MARK-VONOO/SMART-BOTTLE-COLLECTION-SYSTEM-/docs/future-development.md

# SMART BCS Future Development

## Overview

SMART BCS is already a functional bottle collection and reward system, but there are several opportunities to improve its reliability, intelligence, scalability, and suitability for wider deployment.

Future development will focus on improving bottle identification, communication, user management, mechanical robustness, energy efficiency, and data analytics.

---

## 1. Improved Bottle Identification

The current system validates bottles mainly using weight.

A future version could combine weight measurement with:

- Computer vision
- Barcode scanning
- Object recognition
- Material detection
- Shape analysis

This would make it possible to distinguish more accurately between valid PET bottles and unsuitable objects.

---

## 2. Camera-Based Verification

A camera module could be added to inspect inserted bottles.

Possible functions include:

- Detecting bottle shape
- Confirming bottle type
- Detecting bottle caps
- Detecting foreign objects
- Identifying damaged or non-recyclable containers

Computer vision could significantly improve classification accuracy.

---

## 3. Barcode and Product Recognition

A barcode scanner could allow SMART BCS to identify specific beverage products.

This could support:

- Product-specific rewards
- Brand-sponsored recycling campaigns
- Deposit-refund schemes
- Recycling statistics by product type

---

## 4. Mobile Application

A dedicated mobile application could allow registered users to:

- View reward balances
- Review recycling history
- Receive notifications
- Redeem rewards
- Locate nearby SMART BCS stations
- Register new RFID or QR identities

This would improve user engagement and reduce dependence on SMS alone.

---

## 5. QR-Code User Identification

Future versions could support QR-code identification alongside RFID.

Users could scan a personal QR code from a mobile phone to begin a registered recycling session.

This would reduce the need for physical RFID cards.

---

## 6. Cloud-Based User Accounts

The current implementation stores reward information locally using ESP32 NVS.

A future version could synchronize user accounts with a cloud database.

This would allow:

- One user account across multiple machines
- Centralized reward balances
- Remote account management
- Recycling history synchronization
- Multi-location deployments

---

## 7. Web Dashboard

A cloud dashboard could provide system administrators with real-time information such as:

- Number of bottles collected
- Number of active users
- Reward points issued
- Bin-level status
- Machine availability
- SMS delivery status
- Fault conditions
- Recycling trends

This would be useful for schools, municipalities, companies, and recycling organizations.

---

## 8. Multi-Station Networking

Multiple SMART BCS units could be connected to a common platform.

Each unit could report:

- Station ID
- Location
- Collection volume
- Full-bin status
- User transactions
- Technical faults

This would allow SMART BCS to operate as part of a larger smart waste-management network.

---

## 9. GPS / GNSS Integration

Future SMART BCS units could include GNSS positioning.

This would allow each machine to report its physical location automatically.

Location information could be useful for:

- Maintenance teams
- Collection planning
- Public station maps
- Recycling analytics
- Deployment optimization

---

## 10. Improved Mechanical Sorting

The current servo-operated mechanism could be redesigned for higher durability and throughput.

Possible improvements include:

- Stronger mechanical linkages
- Reduced friction
- Industrial bearings
- Better bottle guidance
- Larger sorting channels
- Jam detection
- Automatic jam recovery

A future design could also use a geared motor or linear actuator instead of a hobby servo.

---

## 11. Multiple Waste Categories

Future versions could support more than one recyclable material.

Possible categories include:

- PET plastic
- Aluminum cans
- Glass bottles
- Paper
- Other recyclable plastics

This would require additional sensing and sorting mechanisms.

---

## 12. Larger Collection Capacity

A larger storage bin could increase the number of bottles that can be collected before servicing.

Possible improvements include:

- Larger internal storage
- Bottle compaction
- Multiple collection compartments
- Removable collection bins

---

## 13. Bottle Compaction

A bottle compression mechanism could reduce the storage volume of collected PET bottles.

Benefits could include:

- Increased collection capacity
- Reduced collection frequency
- Easier transportation
- Improved storage efficiency

Safety interlocks would be required for any compaction mechanism.

---

## 14. Improved Bin-Level Detection

The current HC-SR04 system provides basic bin-level monitoring.

Future versions could use:

- Multiple ultrasonic sensors
- Time-of-flight sensors
- Load-based bin monitoring
- Optical sensors

This could provide more reliable estimates when bottles are unevenly distributed.

---

## 15. Industrial Power System

The current system can be improved with a more robust power architecture.

Future versions could include:

- Dedicated regulated rails
- Overcurrent protection
- Reverse-polarity protection
- Surge protection
- Proper fusing
- Industrial DC-DC converters
- Battery backup

This would improve reliability for continuous public operation.

---

## 16. Solar-Powered Operation

A solar-powered version could support installations where mains power is unavailable.

A possible system could include:
Solar Panel
    |
Charge Controller
    |
Battery
    |
DC Regulation
    |
SMART BCS

This could make the system suitable for outdoor and remote locations.

---
## 17. Improved Enclosure

A future enclosure could be designed for long-term public use.

Possible improvements include:

Weather-resistant materials
Lockable access panels
Improved ventilation
Internal cable management
Fire-resistant materials
Tamper-resistant fasteners
Improved bottle-entry geometry
Professional branding

---
## 18. Contactless Reward Redemption

Reward points could eventually be redeemed through:

Mobile-money credit
Shopping vouchers
Campus rewards
Transport credit
Discount coupons
Partner loyalty schemes

This could make recycling incentives more practical and attractive.

---
## 19. Mobile Money Integration

For deployments in Ghana and similar markets, a future version could explore mobile-money reward integration.

Users could potentially convert accumulated recycling points into approved digital rewards.

Such functionality would require secure authentication and compliance with payment-provider requirements.

---
## 20. Enhanced Communication Reliability

Future communication improvements could include:

Wi-Fi
GSM / LTE
LoRaWAN
NB-IoT
Ethernet

Using multiple communication options could improve reliability in different deployment environments.

---
## 21. Remote Firmware Updates

Over-the-air firmware updates could allow software improvements without physically opening the machine.

OTA updates could be used for:

Bug fixes
Security updates
New features
Sensor calibration changes
Reward-policy changes

Secure firmware signing would be important for public deployment.

---
## 22. Improved Security

A larger deployment would require stronger security measures.

Possible improvements include:

Encrypted user records
Secure API authentication
Protected firmware
HTTPS certificate verification
Anti-replay protection
Secure account management
Access-control logging

Private credentials should never be stored in public source-code repositories.

---
## 23. Advanced Analytics

Collected data could be analyzed to understand recycling behavior.

Possible metrics include:

Bottles recycled per day
Most active users
Peak recycling periods
Average bottles per session
Station utilization
Rejection rate
Reward points issued
Collection-bin fill rate

These insights could help improve recycling programs.

---
## 24. Predictive Collection Scheduling

With enough historical bin-level data, SMART BCS could predict when a station is likely to become full.

This could allow collection teams to service machines before overflow occurs.

Predictive scheduling could reduce:

Unnecessary collection trips
Overflow
Machine downtime
Operational costs

---
## 25. Commercial and Community Deployment

Future field trials could evaluate SMART BCS in environments such as:

Universities
Senior high schools
Shopping centres
Offices
Events
Transport terminals
Residential communities
Municipal recycling stations

These deployments would provide real-world information about durability, user behavior, maintenance requirements, and economic viability.

## 26. Manufacturing Development

If SMART BCS moves toward larger-scale production, future work would include:

Custom PCB development
Standardized wiring harnesses
Injection-molded or fabricated enclosure
Improved mechanical assemblies
Certification and safety testing
Manufacturing documentation
Quality-control procedures
Long-Term Vision

The long-term vision for SMART BCS is to develop it from a single functional recycling system into a scalable intelligent recycling platform.

A future SMART BCS network could combine:

Smart Collection Stations
        |
        v
Cloud Platform
        |
        +---- User Accounts
        |
        +---- Rewards
        |
        +---- Recycling Analytics
        |
        +---- Bin Monitoring
        |
        +---- Maintenance Alerts
        |
        +---- Municipal / Company Dashboard

The objective is to make recycling more:

Accessible
Intelligent
Traceable
Rewarding
Data-driven
Environmentally sustainable
Collaboration

SMART BCS is open to future collaboration in areas including:

Embedded systems
IoT
Recycling technology
Automation
Mechanical engineering
Computer vision
Cloud platforms
Sustainability
Smart-city technology
Manufacturing

Potential collaboration could include technical development, field testing, research, sponsorship, manufacturing, and deployment.

---

## Author

MARK VONOO

SMART BCS — Smart Bottle Collection System

Ghana
