MARK-VONOO/SMART-BOTTLE-COLLECTION-SYSTEM-/diagrams/electrical-schematic.pdf

# SMART BCS Controller, RFID and power distribution

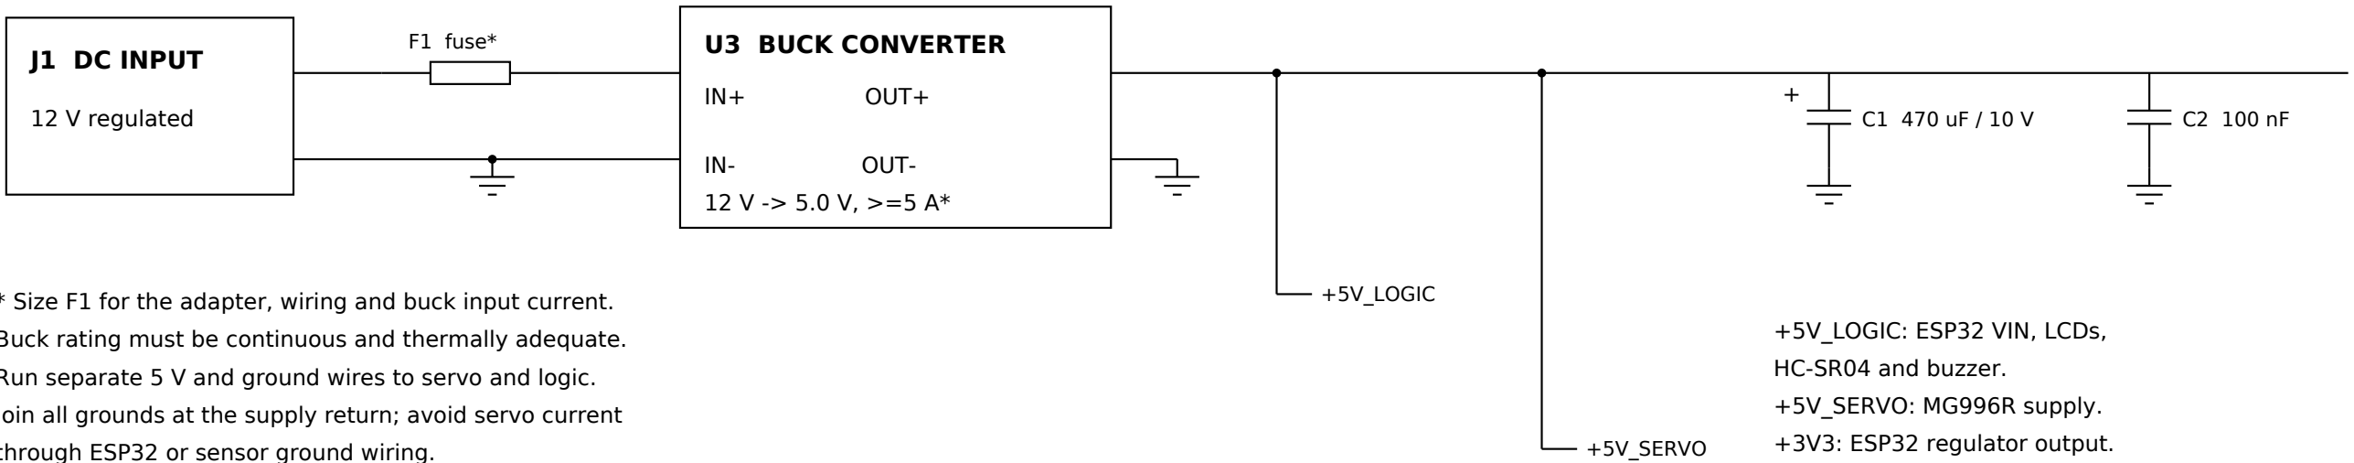
[picture p8: figure]
J1 DC INPUT; 12 V regulated; F1 fuse*; U3 BUCK CONVERTER; OUT+; OUT-; +5V_LOGIC; +5V_LOGIC: ESP32 VIN, LCDs,; HC-SR04 and buzzer.; +5V_SERVO: MG996R supply.; +3V3: ESP32 regulator output.

ELECTRICAL SCHEMATIC | Rev B | 13 Sep 2026 | A3 landscape

GPIO mapping: user-confirmed final build. Interface circuitry is proposed; module outlines show terminals, not physical pin positions.

SHEET 1 OF 3

### U1 ESP32 DevKit / WROOM-32

+5V_LOGIC | 5V / VIN
+3V3 | 3V3
GND | GND
RFID_SS | GPIO5
SPI_SCK | GPIO18
SPI_MOSI | GPIO23
SPI_MISO | GPIO19
RFID_RST | GPIO4
HX_DOUT | GPIO26
HX_SCK | GPIO27
I2C_SDA_3V3 | GPIO21
I2C_SCL_3V3 | GPIO22
GPIO32 | US_TRIG
GPIO33 | US_ECHO_3V3
GPIO13 | SERVO_PWM
GPIO25 | LED_GREEN
GPIO2 | LED_YELLOW
GPIO15 | LED_RED
GPIO14 | BUZZER_EN
GPIO34 | KEY_A
GPIO35 | KEY_B
GPIO36 | KEY_HASH
GPIO39 | KEY_STAR

### U2 RC522 reader

+3V3 | 3.3V
GND | GND
RFID_SS | SDA / SS
SPI_SCK | SCK
SPI_MOSI | MOSI
SPI_MISO | MISO
RFID_RST | RST
IRQ | NC

RC522 SDA is SPI chip select here; it is not I2C SDA. Use 3.3 V power and logic only. IRQ is unconnected. Pin names must be checked against the actual module.

### POWER INPUT AND SEPARATE LOAD BRANCHES

+5V_SERVO

* Size F1 for the adapter, wiring and buck input current. Buck rating must be continuous and thermally adequate. Run separate 5 V and ground wires to servo and logic. Join all grounds at the supply return; avoid servo current
through ESP32 or sensor ground wiring.

Matching net names are electrically connected across all three sheets. Dots indicate junctions; crossings without dots do not connect. Do not feed external 5 V and USB 5 V simultaneously unless your DevKit has verified power isolation.

# SMART BCS Sensor interfaces and dual I2C displays

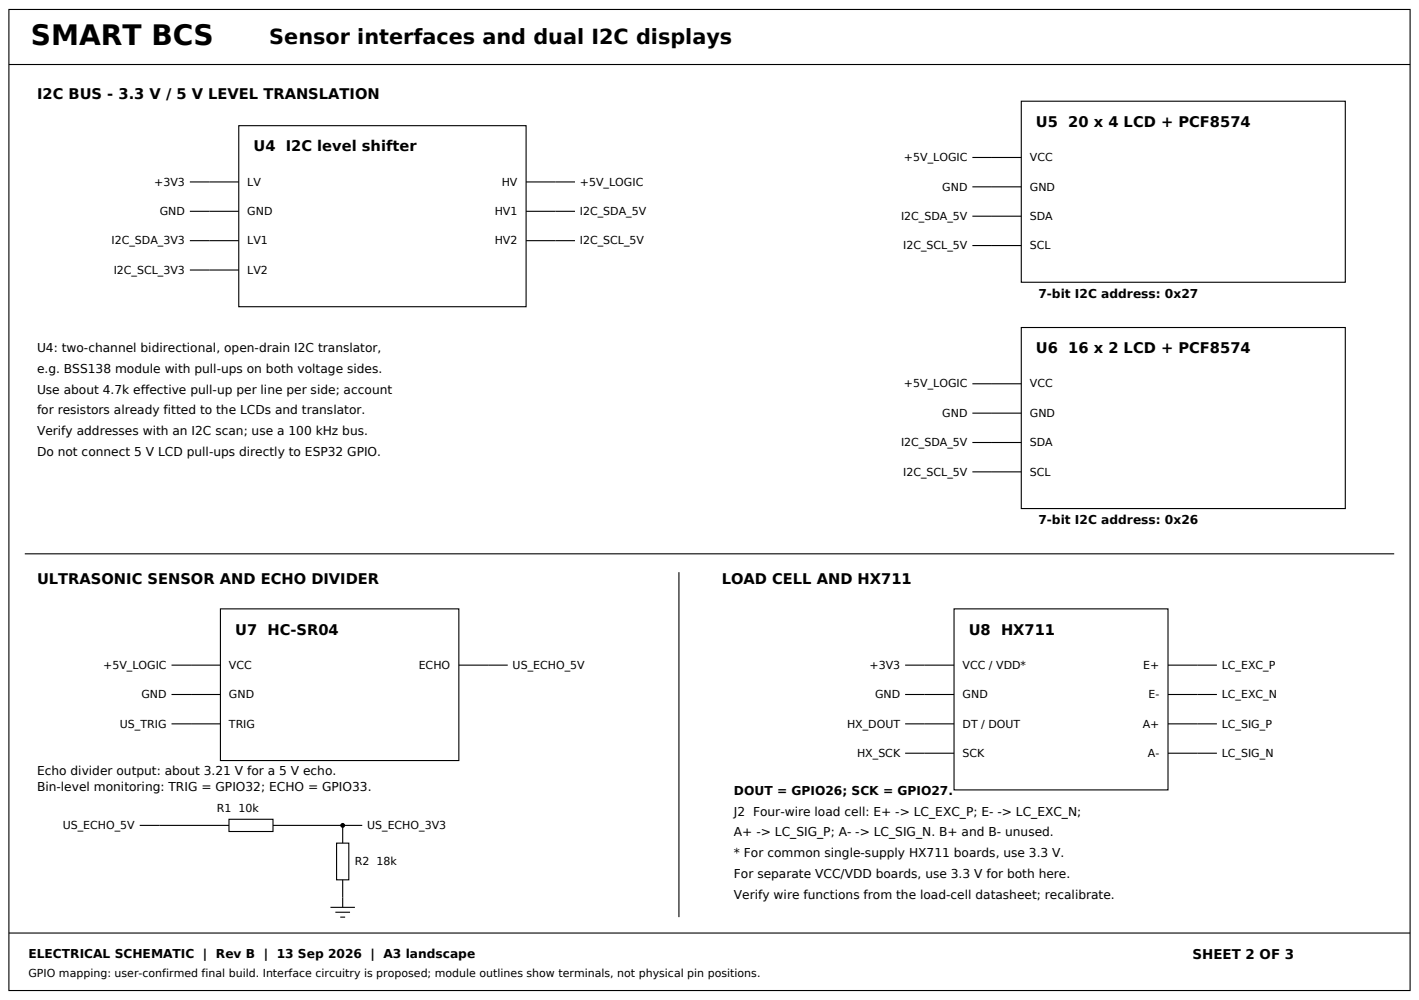
[picture p9: page 2]

U4: two-channel bidirectional, open-drain I2C translator,
e.g. BSS138 module with pull-ups on both voltage sides.
Use about 4.7k effective pull-up per line per side; account
for resistors already fitted to the LCDs and translator.
Verify addresses with an I2C scan; use a 100 kHz bus.
Do not connect 5 V LCD pull-ups directly to ESP32 GPIO.

ULTRASONIC SENSOR AND ECHO DIVIDER

Echo divider output: about 3.21 V for a 5 V echo.
Bin-level monitoring: TRIG = GPIO32; ECHO = GPIO33.

DOUT = GPIO26; SCK = GPIO27.
J2 Four-wire load cell: E+ -> LC_EXC_P; E- -> LC_EXC_N;
A+ -> LC_SIG_P; A- -> LC_SIG_N. B+ and B- unused.
* For common single-supply HX711 boards, use 3.3 V.
For separate VCC/VDD boards, use 3.3 V for both here.
Verify wire functions from the load-cell datasheet; recalibrate.

# SMART BCS Switches, indicators, actuator and build notes

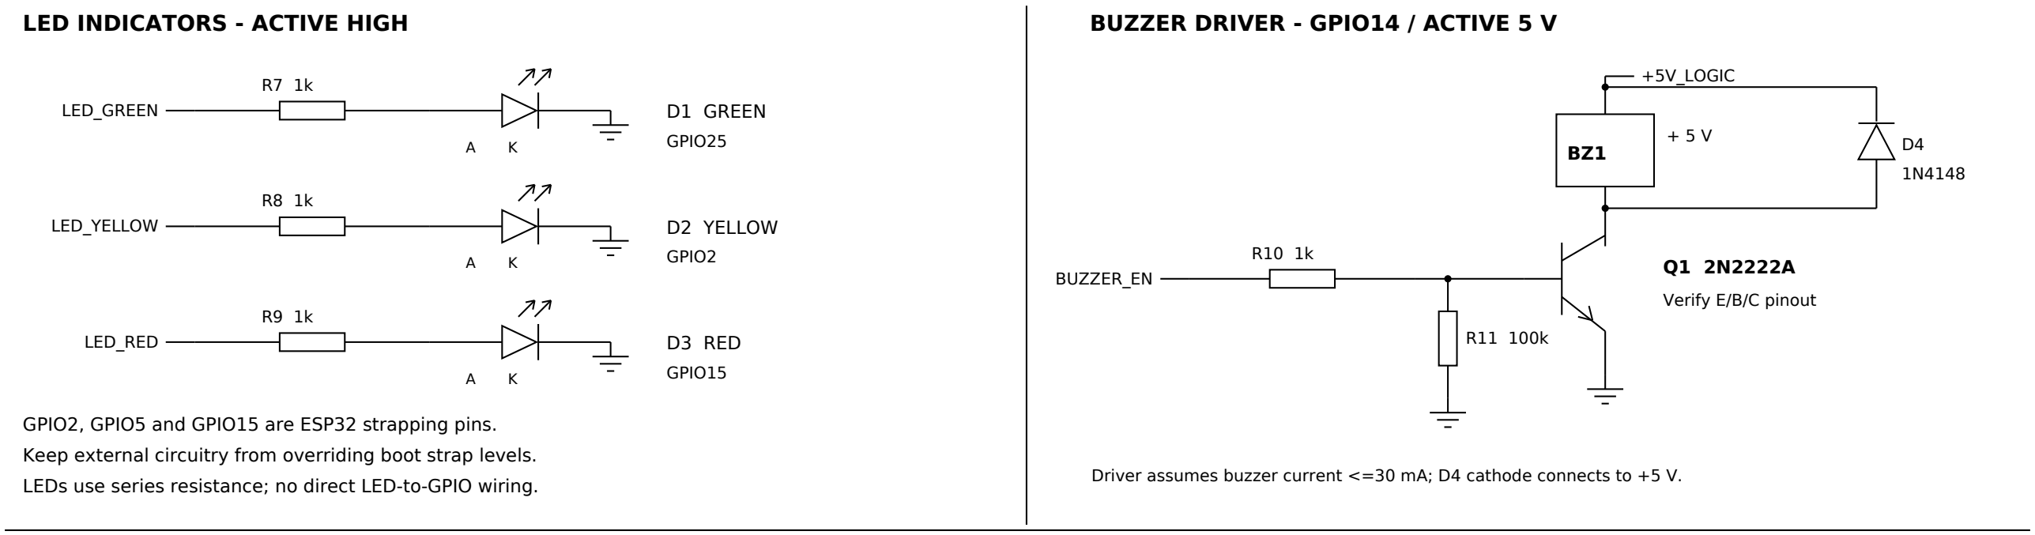
[picture p10: figure]
LED INDICATORS - ACTIVE HIGH; LED_GREEN; D1 GREEN; GPIO25 A; LED_YELLOW; D2 YELLOW; GPIO2 A; LED_RED; D3 RED; GPIO15 A; BUZZER DRIVER - GPIO14 / ACTIVE 5 V; +5V_LOGIC; BUZZER_EN; Verify E/B/C pinout

SHEET 3 OF 3

### FOUR INDEPENDENT NORMALLY OPEN SWITCHES

+3V3

R3 10k

KEY_A

SW1 A

GPIO34

+3V3

R4 10k

KEY_B

SW2 B

GPIO35

+3V3

R5 10k

KEY_HASH

SW3 #

GPIO36

+3V3

R6 10k

KEY_STAR

SW4 *

GPIO39

Pressed = LOW. Each key closes only its own GPIO to ground.
All four keys use input-only GPIOs; fit the 10k pull-ups shown. Four-pin pushbuttons have internally joined pairs; verify with a meter.

### SERVO CONNECTOR - GPIO13

### J3 MG996R

+5V_SERVO | V+
GND | GND
SERVO_PWM | SIGNAL

+5V_SERVO
+
C3 1000 uF / 10 V | C4 100 nF

Fit capacitors near servo connector. Allow >=2 A supply capacity, with margin for actual stall current. Confirm that this servo accepts a 3.3 V control signal.

GPIO2, GPIO5 and GPIO15 are ESP32 strapping pins. Keep external circuitry from overriding boot strap levels. LEDs use series resistance; no direct LED-to-GPIO wiring.

Driver assumes buzzer current <=30 mA; D4 cathode connects to +5 V.

FINAL PIN MAP: A = 34; B = 35; # = 36; * = 39. Servo = 13; buzzer = 14. GPIO assignments match the user-confirmed working mapping. Sources: Espressif ESP32 datasheet; NXP (https://documentation.espressif.com/esp32_datasheet_en.html) PCF8574/PCF8574A datasheet; SparkFun (https://www.nxp.com/documents/data_sheet/PCF8574_PCF8574A.pdf) HX711 hookup guide. Hardware (https://learn.sparkfun.com/tutorials/load-cell-amplifier-hx711-breakout-hookup-guide/all) has not been bench-tested.
