MARK-VONOO/SMART-BOTTLE-COLLECTION-SYSTEM-/diagrams/system-architecture.pdf

# SMART BCS

# System architecture

Automated bottle collection with identification, weight validation, rewards and SMS receipts

REV A

13 SEP 2026

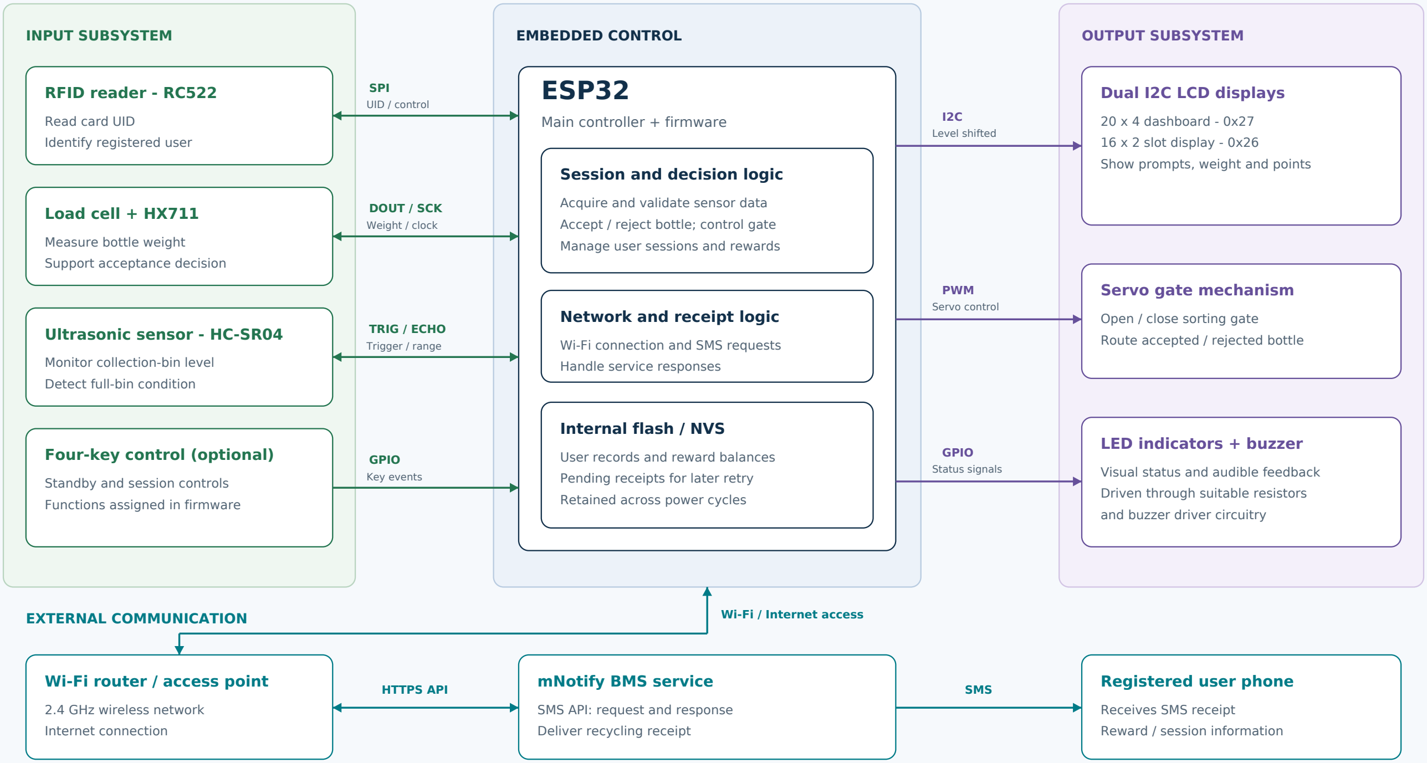
[picture p11: figure]
INPUT SUBSYSTEM; EMBEDDED CONTROL; OUTPUT SUBSYSTEM; RFID reader - RC522; Read card UID; Identify registered user; Load cell + HX711; Measure bottle weight; Support acceptance decision; Ultrasonic sensor - HC-SR04; Monitor collection-bin level; Detect full-bin condition; Four-key control (optional); Standby and session controls; Functions assigned in firmware; ESP32; Main controller + firmware; Session and decision logic; Acquire and validate sensor data; Accept / reject bottle; control gate; Manage user sessions and rewards; Network and receipt logic; Wi-Fi connection and SMS requests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

READING THE DIAGRAM

Arrows show information or control flow. Double arrows indicate commands and returned data.

NVS is inside the ESP32. Power distribution and individual GPIO wiring belong in the separate electrical schematic.
