MARK-VONOO/SMART-BOTTLE-COLLECTION-SYSTEM-/(commit log)

2026-09-13 Add SMART BCS internal wiring image
2026-09-13 Add SMART BCS servo sorting mechanism image
2026-09-13 Add final SMART BCS electrical schematic
